jimmy2217/DIY-Wave-Form-generator/README.md

# DIY-Wave-Form-generator
Features:
- 16x2 LCD display
- Amplitude adjustment
- Offset adjustment
- ON/OFF relay
- Standard BNC connection

Specifications:
- 1Hz to 1MHz range (see report document for triangle and square wave limitations)
- Sine, Triangle and Square waveforms
- 110V 60Hz input power
- 0 t 10V output

All Gerber files and STL files are included



Main Board Sch

Front Board Sch

Supply Board
