jimmy2217/DIY-Wave-Form-generator/Front Board Sch.JPG

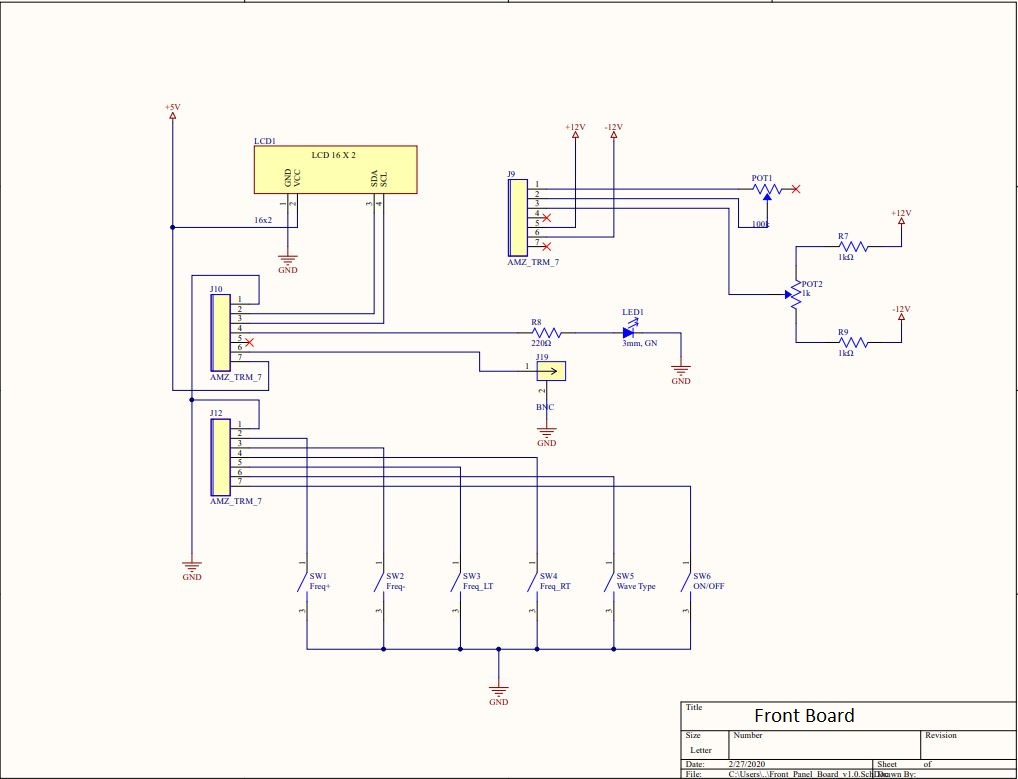
Front Board Sch.JPG
