jimmy2217/DIY-Wave-Form-generator/Main Board Sch.JPG

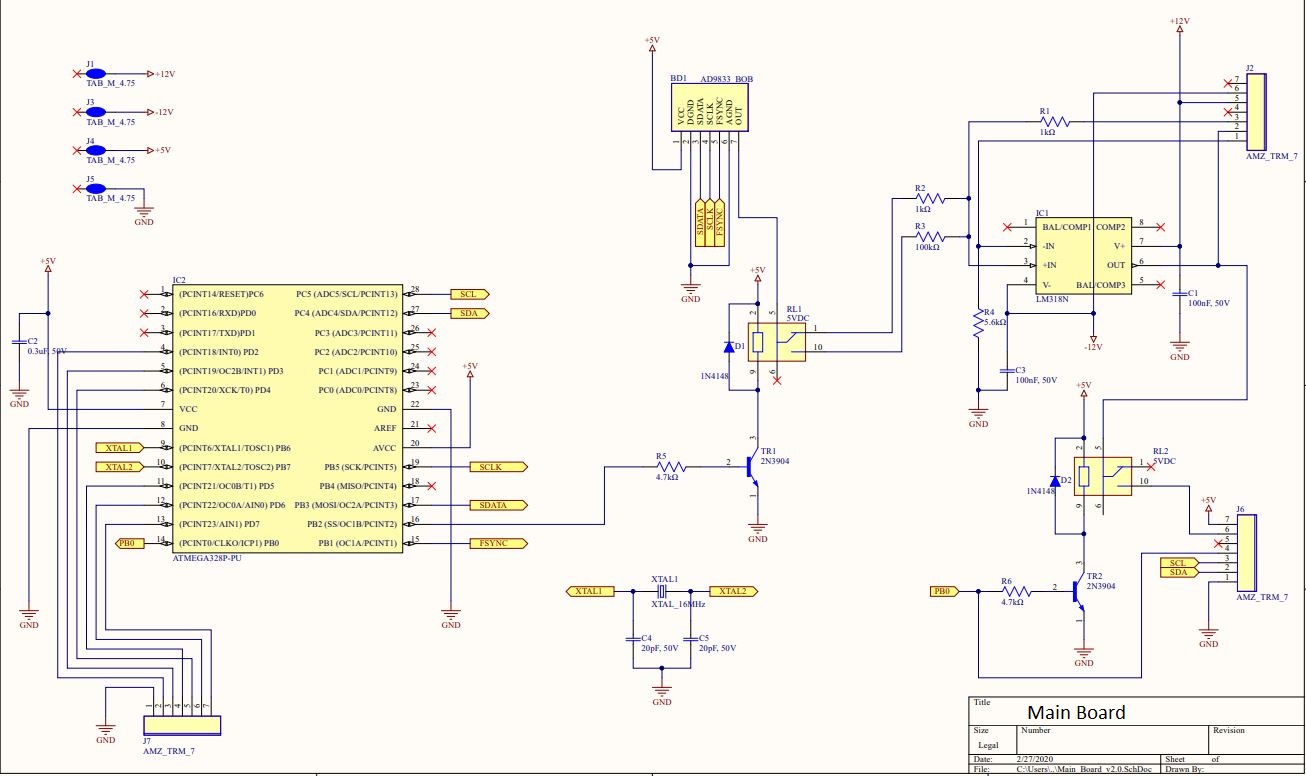
Main Board Sch.JPG
