jimmy2217/DIY-Wave-Form-generator/Supply Board.JPG

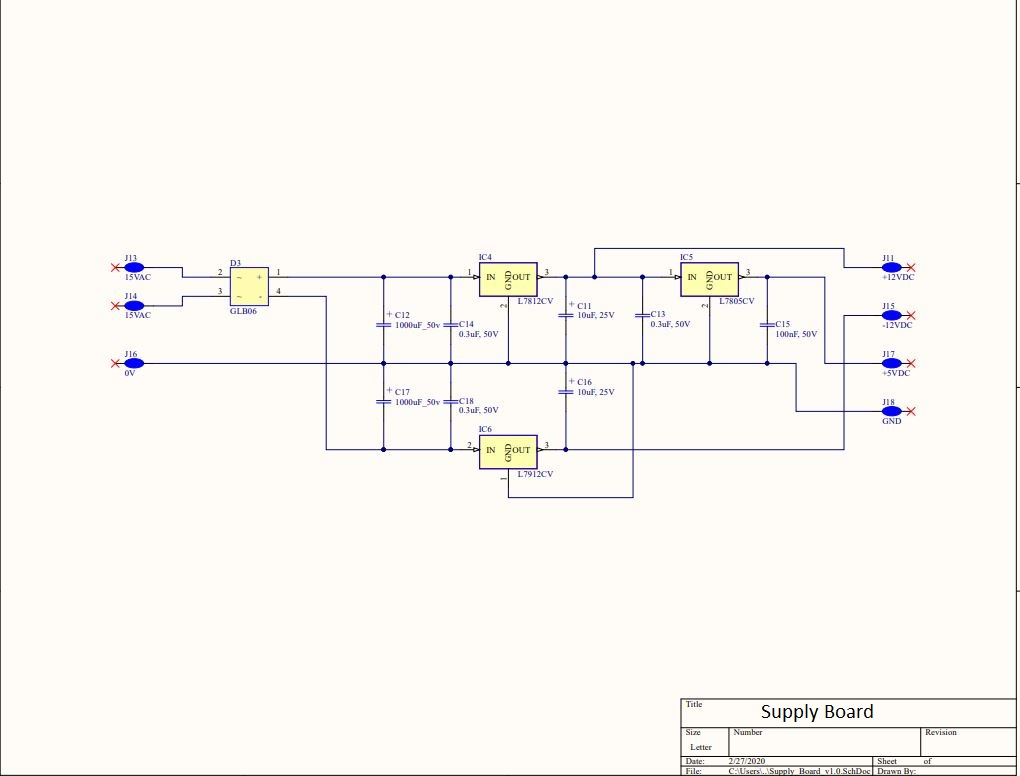
Supply Board.JPG
