jimmy2217/DIY-Wave-Form-generator/Bill of Materials-Func_Gen.xlsx

Sheet: Part List Report
 | Component list |  |  | Bill of Materials for Projectn Function Generator
 | Source Data From: | Func_Gen.PrjPcb |  |  | Contact: |  |  |  | Generated by:
 | Project: | Func_Gen.PrjPcb
 | Variant: | None |  |  | fakhourijamil@gmail.com |  |  |  | Jamil & Adonay
 |  | BEE 425 Project
 | Report Date: | 3/15/2020 | 8:40 PM
 | Print Date: | 2020-03-17 | 23:13:13
# | Category | Manufacturer 1 | Manufacturer Part Number 1 | Case/Package | Description | Quantity | Supplier 1 | Supplier Part Number 1 | Supplier Order Qty 1 | Supplier Stock 1 | Supplier Unit Price 1 | Supplier Subtotal 1 | Supplier Currency 1
1 | Boards |  |  |  | AD9833 BOB, 25MHz XTAL, SPI, 2.54mm Header | 1
2 | Capacitors | Nichicon | UVZ1E100MDD | Radial | CAP ALUM 10UF 20% 25V RADIAL | 3 | Digi-Key | 493-1297-ND | 3 | 0 | 0.24 | 0.72 | USD
3 | Capacitors | KEMET | C333C334J5R5TA | Radial | Cap Ceramic 0.33uF 50V X7R 5% Radial 5.08mm 1 | 2 | Digi-Key | 399-13993-ND | 2 | 1893 | 0.55 | 1.10 | USD
4 | Capacitors | KEMET | C333C334J5R5TA | Radial | Cap Ceramic 0.33uF 50V X7R 5% Radial 5.08mm 125C Bulk | 3 | Digi-Key | 399-13993-ND | 3 | 1893 | 0.55 | 1.65 | USD
5 | Capacitors | Nichicon | UVR1H102MHD | Radial | CAP ALUM 1000UF 20% 50V RADIAL | 2 | Digi-Key | 493-1111-ND | 2 | 21268 | 0.88 | 1.76 | USD
6 | Capacitors | KEMET | C317C200J5G5TA | Radial | Multilayer Ceramic Capacitors MLCC - Leaded 5 | 4 | Digi-Key | 399-8916-ND | 4 | 4083 | 0.50 | 2.00 | USD
7 | Capacitors | KEMET | C322C104K5R5TA7301 | Radial | Multilayer Ceramic Capacitors MLCC - Leaded 5 | 9 | Digi-Key | 399-9877-1-ND | 9 | 48964 | 0.25 | 2.25 | USD
8 | Connectors | Glark |  |  | Amzon terminal kit, 7 pin | 6 | Amazon |  |  |  | 0.02
9 | Connectors | Glark |  |  | Terminal 7 pin, amazon | 3 | Amazon |  | 1180 |  | 16.54
10 | Connectors | TE Connectivity | 1-1634505-0 |  | CONN BNC JACK STR 50 OHM PCB | 1 | Digi-Key | A97558-ND | 1 | 520 | 2.58 | 2.58 | USD
11 | Crystals | ECS International | ECS-160-20-4X |  | CRYSTAL 16.0000MHZ 20PF T/H | 2 | Digi-Key | X1103-ND | 2 | 1111 | 0.69 | 1.38 | USD
12 | Crystals | Abracon | ACH-25.000MHZ-EK |  | OSC XO 25.000MHZ TTL PC PIN | 1 | Digi-Key | 535-9175-5-ND | 1 | 5433 | 1.97 | 1.97 | USD
13 | Diodes | Vishay Semiconductors | GBL06-E3/51 | SIP | Bridge Rectifiers 600 Volt 4.0 Amp Glass Pass | 1 | Digi-Key | GBL06-E3/51GI-ND | 1 | 1098 | 1.24 | 1.24 | USD
14 | Diodes | NXP Semiconductors | 1N4148 | SOD | NEXPERIA - 1N4148 - DIODE, 1N4148 AMMO-BOX 10 | 4 | Digi-Key | 1N4148FS-ND | 4 | 197068 | 0.10 | 0.40 | USD
15 | Displays |  |  |  | LCD screen 16 x 2, I2C comm, back light. | 1 | Amazon |  |  |  | 9
16 | ICs | Analog Devices | AD9833BRMZ | MSOP | Data Acquisition ADCs/DACs - Specialized 12.6 | 1 | Digi-Key | AD9833BRMZ-ND | 1 | 0 | 10.04 | 10.04 | USD
17 | ICs | TI National Semiconductor | LM318N/NOPB | PDIP | TEXAS INSTRUMENTS LM318N/NOPB | 2 | Digi-Key | LM318N/NOPB-ND | 2 | 1327 | 1.10 | 2.20 | USD
18 | ICs | Microchip | ATMEGA328PU | PDIP | ATMEL ATMEGA328-PU 8 Bit M | 2 | Digi-Key | ATMEGA328-PU-ND | 2 | 0 | 1.90 | 3.80 | USD
19 | ICs | STMicroelectronics | L7812CV | TO | STMICROELECTRONICS L7812CV | 1 | Digi-Key | 497-1452-5-ND | 1 | 12373 | 0.45 | 0.45 | USD
20 | ICs | STMicroelectronics | L7912CV | TO-220 | STMICROELECTRONICS L7912CV | 1 | Digi-Key | 497-1476-5-ND | 1 | 769 | 0.49 | 0.49 | USD
21 | ICs | STMicroelectronics | L7805CV-DG | TO-220 | IC REG LINEAR 5V 1.5A TO220 | 1 | Digi-Key | 497-12404-ND | 1 | 3166 | 0.57 | 0.57 | USD
22 | LEDs | Wurth Electronics | 151031VS06000 | Radial | WURTH ELEKTRONIK 151031VS06000 LED, 3MM, | 1 | Digi-Key | 732-5008-ND | 1 | 11535 | 0.16 | 0.16 | USD
23 | Potentiometers | TT BI | P160KN-0QC15B100K |  | POT 100K OHM 1/5W PLASTIC LINEAR | 1 | Digi-Key | 987-1300-ND | 1 | 693 | 0.79 | 0.79 | USD
24 | Potentiometers | TT BI | P160KN-0QD15B1K |  | POT 1K OHM 1/5W PLASTIC LINEAR | 1 | Digi-Key | 987-1309-ND | 1 | 1128 | 0.79 | 0.79 | USD
25 | Relays | Omron | G5V-1-T90DC5BYOMZ |  | RELAY GEN PURPOSE SPDT 1A 125V | 4 | Digi-Key | Z6370-ND | 4 | 572 | 1.88 | 7.52 | USD
26 | Resistors | Stackpole Electronics | RNMF14FTC220R | Axial | RES 220 OHM 1/4W 1% AXIAL | 1 | Digi-Key | S220CACT-ND | 1 | 40767 | 0.10 | 0.10 | USD
27 | Resistors | Stackpole Electronics | RNMF14FTC4K70 | Axial | RES 4.7K OHM 1/4W 1% AXIAL | 4 | Digi-Key | S4.7KCACT-ND | 4 | 73448 | 0.10 | 0.40 | USD
28 | Resistors | Stackpole Electronics | CF14JT5K60 | Conformal | RES 5.6K OHM 1/4W 5% AXIAL | 2 | Digi-Key | CF14JT5K60CT-ND | 2 | 2366 | 0.10 | 0.20 | USD
29 | Resistors | Stackpole Electronics | RNF14FTD100K | Conformal | RES 100K OHM 1/4W 1% AXIAL | 2 | Digi-Key | RNF14FTD100KCT-ND | 2 | 62207 | 0.10 | 0.20 | USD
30 | Resistors | Stackpole Electronics | CF14JT1K00 | Conformal | RES 1K OHM 1/4W 5% AXIAL | 6 | Digi-Key | CF14JT1K00CT-ND | 6 | 581704 | 0.10 | 0.60 | USD
31 | Switches | ALCOSWITCH - TE CONNECTIVITY | 1825910-6 |  | ALCOSWITCH - TE CONNECTIVITY - 1825910-6 - TACT SWITCH, SPST, 0.05A, 24VDC, SOLDER | 6 | Digi-Key | 450-1650-ND | 6 | 0 | 0.10 | 0.60 | USD
32 | Terminals | Molex | 0197084011 |  | PCB Tab Quick Disconnect, Male, for Wire, Box | 16 | Digi-Key | WM6456-ND | 16 | 1194 | 0.20 | 3.28 | USD
33 | Transistors | Rochester Electronics | 2N3904BU | TO-92 | TRANS NPN 40V 0.2A TO-92 | 4 | Digi-Key | 2N3904FS-ND | 4 | 0 | 0.20 | 0.80 | USD
 |  |  |  |  |  | 99 |  |  | 88 |  |  | 50.04
Approved |  |  |  | Notes
 |  |  |  |  |  | 1 | pcs: | Total |  | 50.04 |  | USD
 |  |  |  |  |  |  |  | Price for 1pcs |  | 50.04 |  | USD

Sheet: Project Information
Project Full Path | C:\Users\jimmy\OneDrive\School\BEE 425\Labs\Project\Altium\Func_Gen\Func_Gen.PrjPcb
Project Filename | Func_Gen.PrjPcb
Variant Name | None
Data-Source Filename | Func_Gen.PrjPcb
Data-Source Full Path | C:\Users\jimmy\OneDrive\School\BEE 425\Labs\Project\Altium\Func_Gen\Func_Gen.PrjPcb
Title | Bill of Materials for Project [Func_Gen.PrjPcb] (No PCB Document Selected)
Total Quantity | 99
Report Time | 8:40 PM
Report Date | 3/15/2020
Report Date & Tine | 3/15/2020 8:40 PM
Output Name | Bill of Materials
Output Type | BOM_PartType
Output Generator Name | BOM
Output Generator Description | Bill of Materials
